EosinY/ElectronicLoad-AnalogController/GreenPAK_schem.pdf

(

)

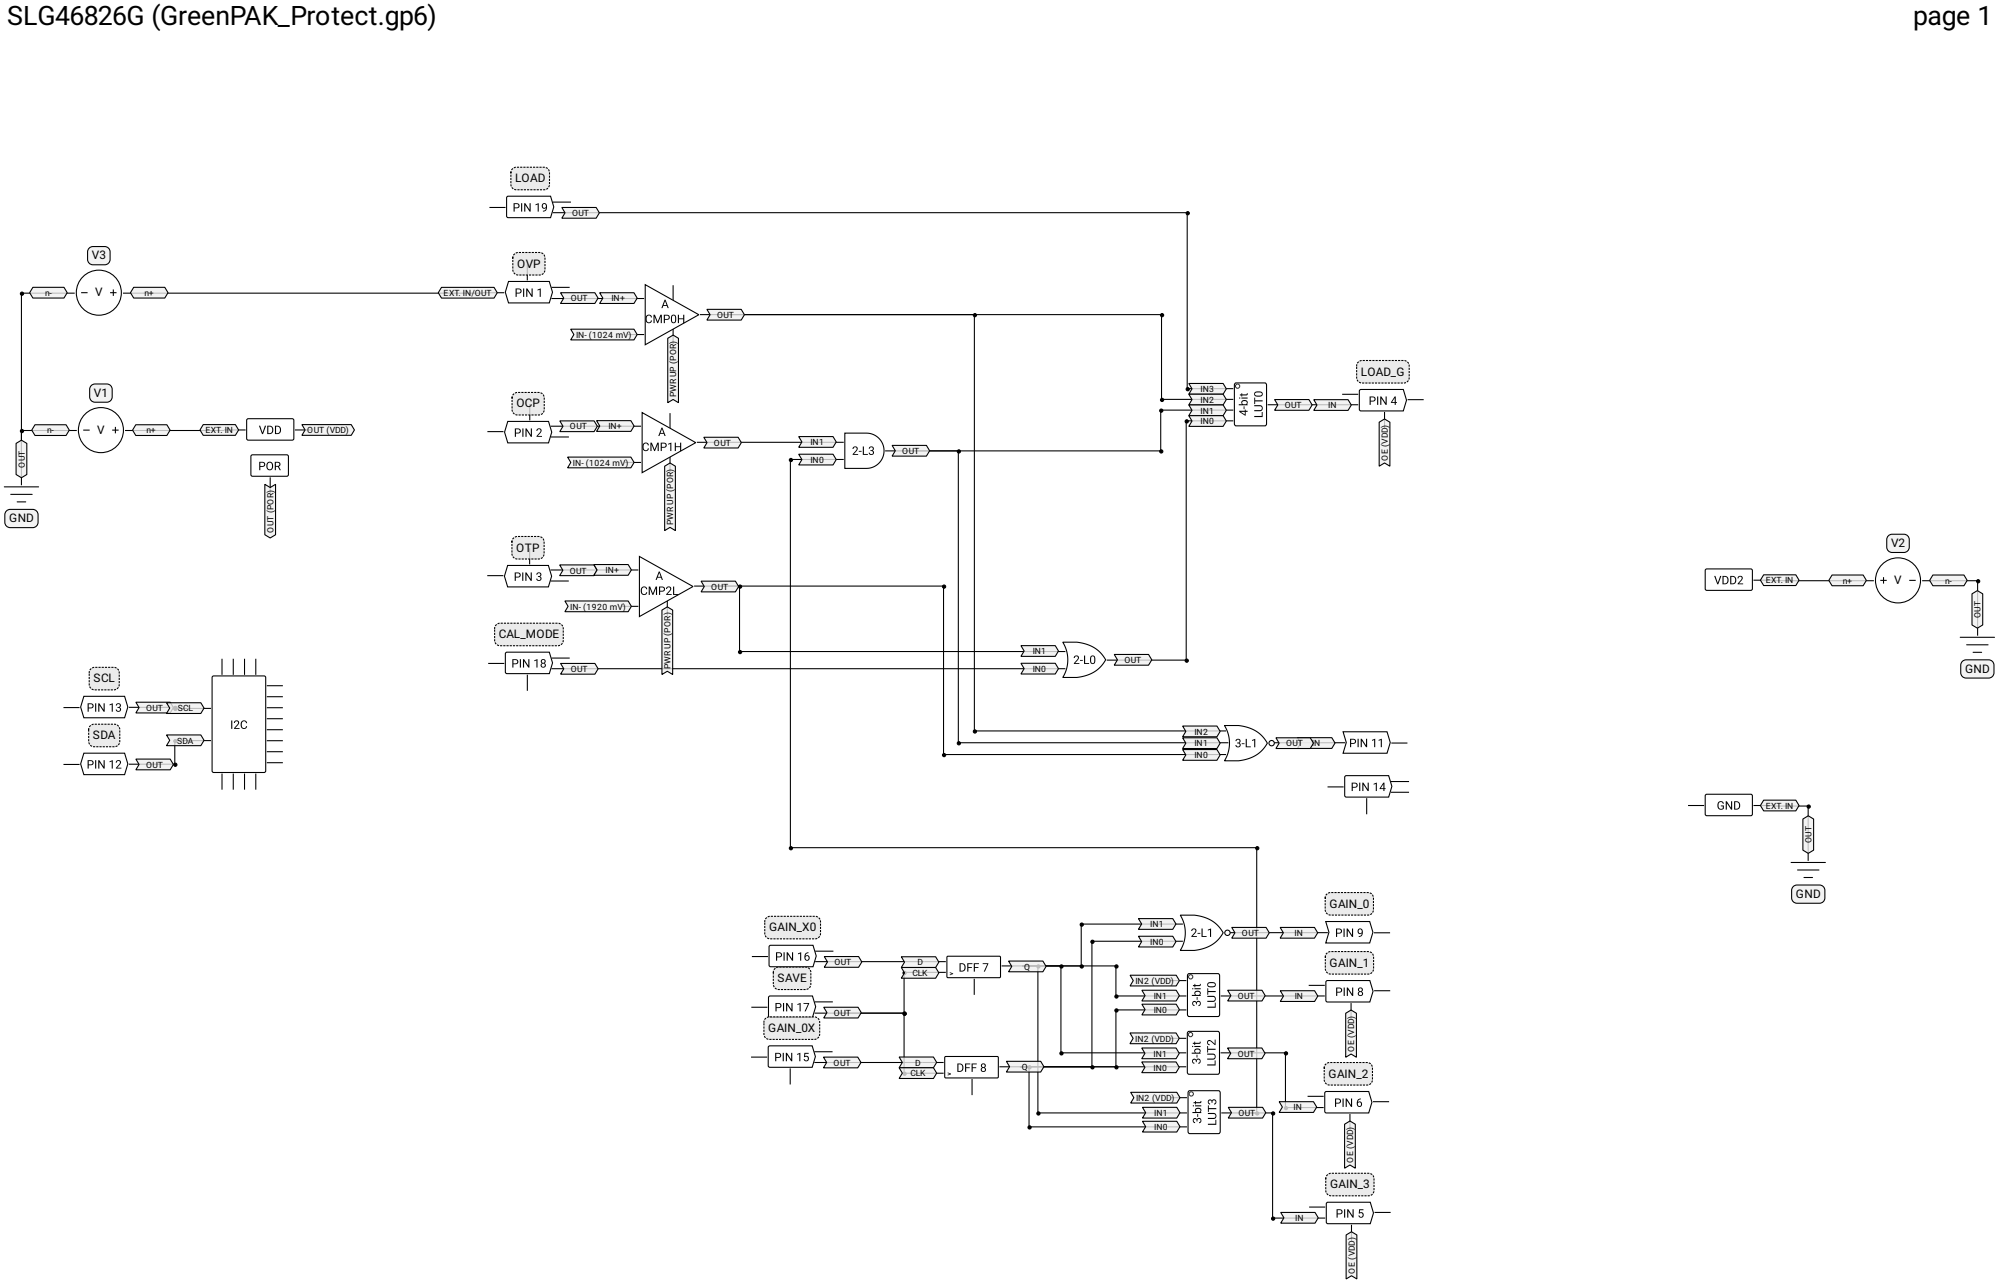
[picture p1: page 1]
AIN; OUT; IN2 (VDD) IN1 IN0; OUT IN2 IN1 IN0; T IN2 (VDD) IN1 IN0; OUT IN2 (VDD) IN1 IN0

PWR UP (POR) IN+ IN- (1024 mV)

OE (VDD) IN LOAD

PWR UP (POR) IN+ IN- (1920 mV)

OUT (POR) IN

PWR UP (POR)

OE (VDD) IN GAIN

V

D

D

I

N

2

0

Pr o p e r ty | Va l u e
Min. v alu ( V ) e | 2.3 0
T
y
p. v

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
x. v

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
Pr o p e r ty | Va l u
| Digital input In mode Digital in without Sch e I/O selection

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
Pr o p e r ty | l Va u
| Digital input In mode Digital in without Sch e I/O selection

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
ull D
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
Pr o p e r ty | l Va u
e I/O selection | Digital input In mode | Digital in without Sch

mit
t

t

rig
g

e

r
O u t m o d e | N o n e
R sis e t o r | Flo tin a g

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
Pr o p e r ty | Va l u
| Digital input In mode Digital in without Sch e I/O selection
| mit t t rig g e r
O d u m | N
R sis | Flo tin

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
e I/O selection | Digital input In mode | Digital in without Sch

mit
t

t

rig
g

e

r
O u t m o d e | N o n e
R e sis t o r | Flo a tin g

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
Pr o p e r ty | l Va u
e I/O selection | Digital input In mode | Digital in without Sch

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
Pr o p e r ty | Va l u
e I/O selection | Digital input In mode | Digital in without Sch

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
Pr o p e r ty | Va l u
| Digital input In mode Digital in without Sch e I/O selection

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
e I/O selection | Digital output In mode | None Out mode | 2x push pull | P

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
e I/O selection | Digital output In mode | None Out mode | 1x push pull PIN 8 (IO8) Label: "GAIN_1" Property | Value I/O selection | Digital output In mode | None Out mode | 1x push pull VDD2 (PIN 7) Property | Value Min. value (V) | 1.71 Typ. value (V) | 5.00 Max. value (V) | 5.50 PIN 6 (IO9) Label: "GAIN_2" Property | Value I/O selection | Digital output In mode | None Out mode | 1x push pull PIN 5 (IO10) Label: "GAIN_3" Property | Value I/O selection | Digital output In mode | None Out mode | 1x push pull SLG46826G (GreenPAK_Protect.gp6)

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
Pr o p e r ty | Va l u
e I/O selection | Digital output In mode | None Out mode | 1x push pull PIN 3 (IO12) Label: "OTP" Property | Value I/O selection | Analog input/output In mode | Analog input/output Out mode | Analog input/output Resistor | Floating PIN 2 (IO13) Label: "OCP" Property | Value I/O selection | Analog input/output In mode | Analog input/output Out mode | Analog input/output Resistor | Pull Down Resistor value | 1M PIN 1 (IO14) Label: "OVP" Property | Value I/O selection | Analog input/output In mode | Analog input/output Out mode | Analog input/output Resistor | Pull Down Resistor value | 1M 100uA pullup on input | Enable

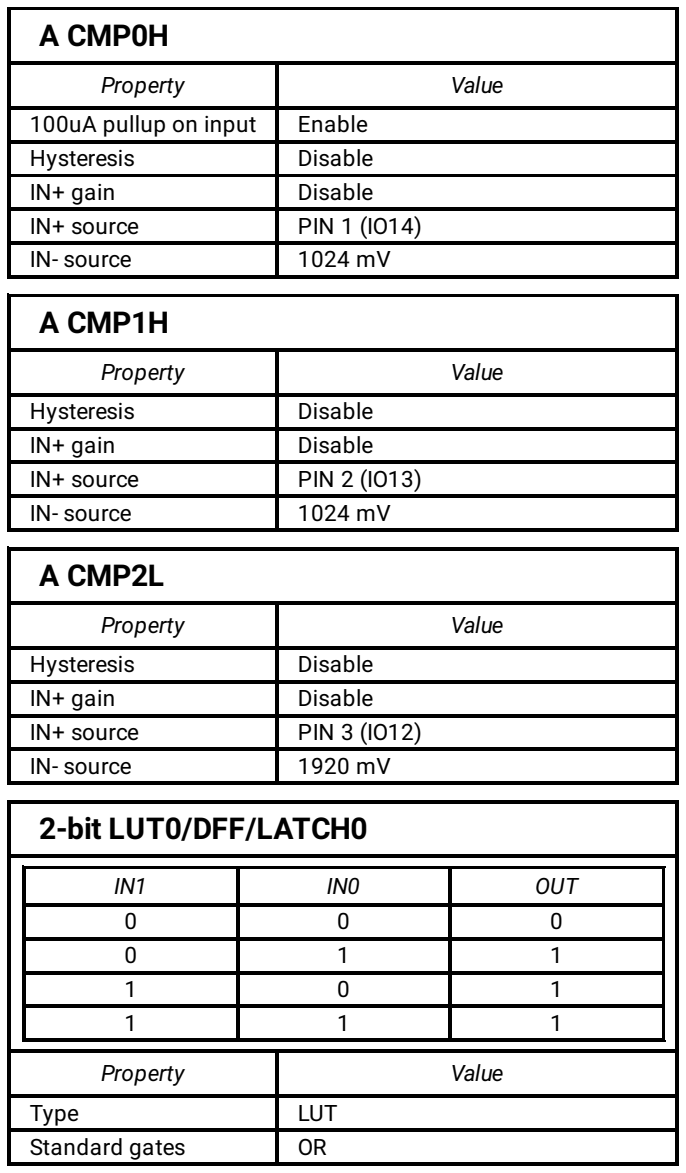
[picture p2: figure]
ullu; ble; sis; Dis a; ble IN+ gain; Disable IN+ source; PIN 1 (IO; ) IN- source; 1024 mV A CMP1H Property; 1024 mV A CMP2L Property; H sis y s t e r e; PIN 3 (IO; 1920 mV 2-bit LUT0/DFF/LATCH0 IN1

Disable IN+ source PIN 2 (IO ble IN+ gain

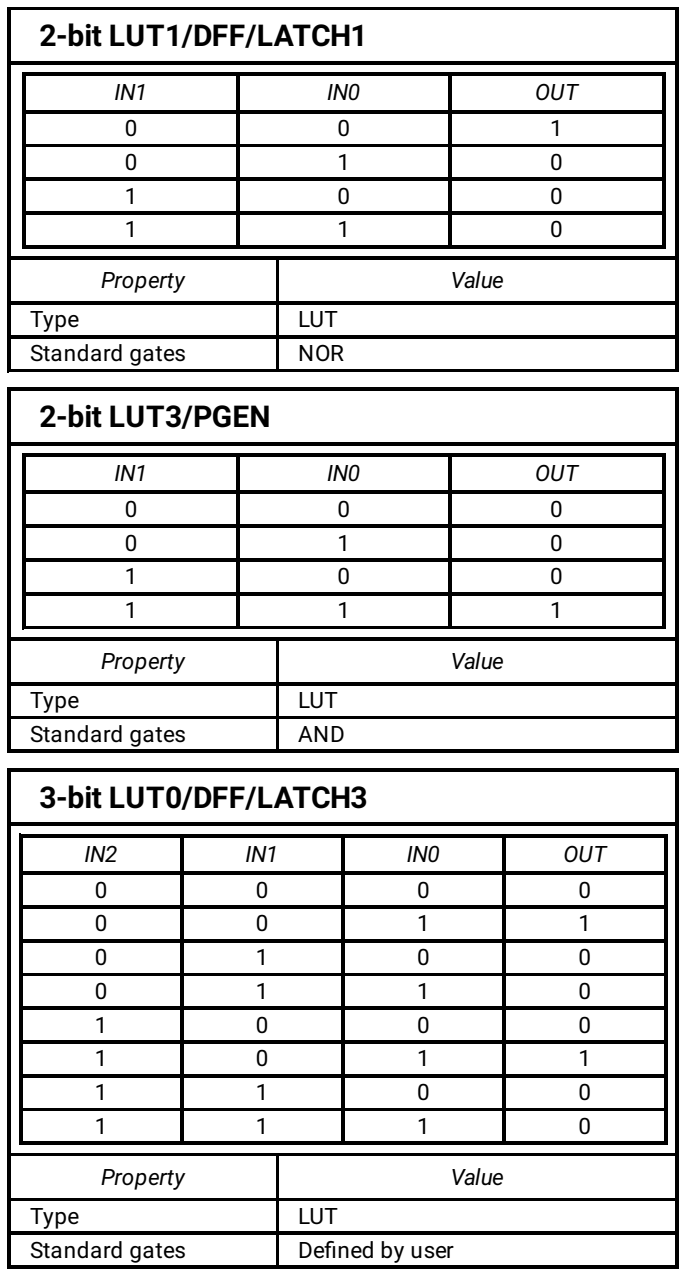
[picture p3: figure]
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

### 3-bit LUT1/DFF/LATCH4

IN2 | IN1 | IN0 | OUT
0 | 0 | 0 | 1
0 | 0 | 1 | 0
0 | 1 | 0 | 0
0 | 1 | 1 | 0
1 | 0 | 0 | 0
1 | 0 | 1 | 0
1 | 1 | 0 | 0
1 | 1 | 1 | 0
Property | Value
Type | LUT
Standard gates | NOR

### 3-bit LUT2/DFF/LATCH5

IN2 | IN1 | IN0 | OUT
0 | 0 | 0 | 0
0 | 0 | 1 | 0
0 | 1 | 0 | 1
0 | 1 | 1 | 0
1 | 0 | 0 | 0
1 | 0 | 1 | 0
1 | 1 | 0 | 1
1 | 1 | 1 | 0
Property | Value
Type | LUT
Standard gates | Defined by user

### 3-bit LUT3/DFF/LATCH6

IN2 | IN1 | IN0 | OUT
0 | 0 | 0 | 0
0 | 0 | 1 | 0
0 | 1 | 0 | 0
0 | 1 | 1 | 1
1 | 0 | 0 | 0
1 | 0 | 1 | 0
1 | 1 | 0 | 0
1 | 1 | 1 | 1
Property | Value
Type | LUT
Standard gates | | Defined by user

### 3-bit LUT4/DFF/LATCH7

Property | Value
Type | DFF / LATCH
Mode | DFF
nSET/nRESET option | nRESET
Initial polarity | Low
Q output polarity | | Non-inverted (Q)

### 3-bit LUT5/DFF/LATCH8

Property | Value
Type | DFF / LATCH
Mode | DFF
nSET/nRESET option | nRESET
Initial polarity | Low
Q output polarity | Non-inverted (Q)

### MF0 (4-bit LUT0, DFF/LATCH9, WS Ctrl, 16-bit CNT0/DLY0/FSM0)

### 4-bit LUT0 (MF0)

IN3 | IN2 | IN1 | IN0 | OUT
0 | 0 | 0 | 0 | 0
0 | 0 | 0 | 1 | 0
0 | 0 | 1 | 0 | 0
0 | 0 | 1 | 1 | 0
0 | 1 | 0 | 0 | 0
0 | 1 | 0 | 1 | 0
0 | 1 | 1 | 0 | 0
0 | 1 | 1 | 1 | 0
1 | 0 | 0 | 0 | 1
1 | 0 | 0 | 1 | 0
1 | 0 | 1 | 0 | 0
1 | 0 | 1 | 1 | 0
1 | 1 | 0 | 0 | 0
1 | 1 | 0 | 1 | 0
1 | 1 | 1 | 0 | 0
1 | 1 | 1 | 1 | 0
Property | Value
Standard gates | Defined by user
SLG46826G (GreenPAK_Protect.gp6) | page 4

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
e IO Latching | Enable Mode selection | Standard/fast mode Control code, bin | 0001 Control byte, read/ write | 0x11 / 0x10 Device address, dec/ hex | 8 / 0x08 PIN 19 (IO0) output expander select | From matrix PIN 14 (IO5) output expander select | From matrix PIN 11 (IO6) output expander select | From matrix PIN 6 (IO9) output expander select | From matrix Virtual OUT0 | 0 Virtual OUT1 | 0 Virtual OUT2 | 0 Virtual OUT3 | 0 Virtual OUT4 | 0 Virtual OUT5 | 0 Virtual OUT6 | 0 Virtual OUT7 | 0 PIN 19 (IO0) OUT | 0 PIN 14 (IO5) OUT | 0 PIN 11 (IO6) OUT | 0 PIN 6 (IO9) OUT | 0 Control code selection | #3 | #2
| | # 1 | # 0
0 | 0 | 0 | 1

V

1

Pr o p e r ty | l Va u e
Ele m e n t | V olt a g e S o u r c e
P d ela r e -s t a r t y | 0 10 s Internal capacitance
| 0 n
F Internal resistance | 10Ohm Pre-start state | Low Type | DC DC Voltage | 3.3V Ramp rise time | 1ms V2 Property
| Va l u e
Ele m e n t | olt V a g e S o u r c e
P r e -s t a r t d ela y | 0 10 s Internal capacitance
| 0 n
F Internal resistance | 10Ohm Pre-start state | Low Type | DC DC Voltage | 3.3V Ramp rise time | 1ms V3 Property
| Va l u e
Ele m e n t | V olt S a g e o u r c e
T y p e | D C
D C V olt a g e | 3.3 V

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
n. | Typ. | M
ax. VDD | 2.30 | 5.00 | 5.50 VDD2 (V): | 1.71 | 5.00 | 5.50 Temperature (°C): | -40.00 | 25.00 | 85.00 General Settings GPIO quick charge | Disable Pattern ID | 1 2k Register lock status | Unlocked 2k NVM lock status | Unlocked Emulated EEPROM lock status | Unlocked Protect entire lock configuration | Disable

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
X: 0
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
C: 1
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
X: 0
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
C: 1
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
X: 0
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
C: 1
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
X: 0
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
C: 1
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
X: 0
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
C: 1
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
X: 0
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
C: 1
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
X: 0
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
C: 1
1
6

`

b
6

PIN 8 (IO 8 ) -> O U T | H E X: 0 x 7 4 ` b 7 ` b D E C: 1 1 6 7 | -
(IO ) PIN 6 9 -> O U T | ` b H E X: 0 x 7 5 0 D E C: 1 1 7 ` b 0 | -
PIN 5 (IO 1 0 ) -> O U T | H E X: 0 x 7 5 ` b 1 ` b D E C: 1 1 7 1 | -
(IO ) PIN 4 1 1 -> O U T | ` b H E X: 0 x 7 5 2 D E C: 1 1 7 ` b 2 | -

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
X: 0
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
C: 1
1
7

`

b
3

(IO ) PIN 2 1 3 -> O U T | N E T 9 | ` b H E X: 0 x 7 5 4 D E C: 1 1 7 ` b 4 | -
PIN 1 (IO 1 4 ) -> O U T | N E T 8 | H E X: 0 x 7 5 ` b 5 ` b D E C: 1 1 7 5 | -
bit 2 -L U T 0 / D F F / L AT C H 0 -> O U T | N E T 2 2 | ` b H E X: 0 x 7 5 6 D E C: 1 1 7 ` b 6 | +

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
X: 0
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
C: 1
1
7

`

b
7

+

bit -U T / D F F / AT H -> O U T | | ` b H E X: 0 x D E C: 1 ` b | -
-bit U T / E N -> | N E T | H E X: 0 x ` b | +

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
C: 1
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
X: 0
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
C: 1
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
X: 0
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
C: 1
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
X: 0
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
C: 1
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
X: 0
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
C: 1
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
X: 0
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
C: 1
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
X: 0
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
C: 1
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
X: 0
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
C: 1
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
X: 0
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
C: 1
1

9

`

b
1

bit 3 -L U T 6 / Pip e D ela y / Rip ple C o u n t e r -> Q 2 | ` b H E X: 0 x 7 7 2 D E C: 1 1 9 ` b 2 | -
FILT E R/ E D G E D E T -> O U T | ` b H E X: 0 x 7 7 3 D E C: 1 1 9 ` b 3 | -

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
X: 0
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
C: 1
1

9

`

b
4

bit 8 -C N T 1 / D LY 1 ( M F 1 ) -> O U T | ` b H E X: 0 x 7 7 5 D E C: 1 1 9 ` b 5 | -
O S C 1 -> O U T 0 | H E X: 0 x 7 7 ` b 6 ` b D E C: 1 1 9 6 | -
O S C 0 -> O U T 0 | ` b H E X: 0 x 7 7 7 D E C: 1 1 9 ` b 7 | -

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
X: 0
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
C: 1

2

0

`

b
0

bit -N T / D LY M F -> O U T | ` b H E X: 0 x D E C: 1 ` b | -

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
X: 0
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
C: 1

2

0

`

b
2

8 -bit C N T 4 / D LY 4 ( ) M F 4 -> O U T | | H E X: 0 x 7 8 ` b 3 ` b D E C: 1 2 0 3 | -
bit 8 -C N T 5 / D LY 5 ( M F 5 ) -> O U T | | ` b H E X: 0 x 7 8 4 D E C: 1 2 0 ` b 4 | -
8 -bit C N T 6 / D LY 6 ( ) M F 6 -> O U T | | H E X: 0 x 7 8 ` b 5 ` b D E C: 1 2 0 5 | -
bit 8 -C N T 7 / D LY 7 ( M F 7 ) -> O U T | | ` b H E X: 0 x 7 8 6 D E C: 1 2 0 ` b 6 | -
4 -bit L U T 0 ( M F 0 ) -> O U T | N E T 2 7 | H E X: 0 x 7 8 ` b 7 ` b D E C: 1 2 0 7 | +
bit ( ) 3 -L U T 7 M F 1 -> O U T | | ` b H E X: 0 x 7 9 0 D E C: 1 2 1 ` b 0 | -
3 -bit L U T 8 ( M F 2 ) -> O U T | | H E X: 0 x 7 9 ` b 1 ` b D E C: 1 2 1 1 | -

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
X: 0
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
C: 1

2
1

`

b
2

3 -bit L U T 1 0 ( M F 4 ) -> O U T | H E X: 0 x 7 9 ` b 3 ` b D E C: 1 2 1 3 | -
bit ( ) 3 -L U T 1 1 M F 5 -> O U T | ` b H E X: 0 x 7 9 4 D E C: 1 2 1 ` b 4 | -
3 -bit L U T 1 2 ( M F 6 ) -> O U T | H E X: 0 x 7 9 ` b 5 ` b D E C: 1 2 1 5 | -
bit ( ) 3 -L U T 1 3 M F 7 -> O U T | ` b H E X: 0 x 7 9 6 D E C: 1 2 1 ` b 6 | -
1 6 -bit C N T 0 / D LY 0 / ( ) F S M 0 M F 0 -> O U T | H E X: 0 x 7 9 ` b 7 ` b D E C: 1 2 1 7
| HEX: 0x7A`b0 DEC: 122`b0 HEX: 0x7A`b1 DEC: 122`b1 HEX: 0x7A`b2 DEC: 122`b2 HEX: 0x7A`b3 DEC: 122`b3 | - I2C -> OUT7 - I2C -> OUT6 - I2C -> OUT5 - I2C -> OUT4 -

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
s I2C -> OUT3

` b H E X: 0 x 7 A 4 D E C: 1 2 2 ` b 4
HEX: 0x7A`b5 DEC: 122`b5 HEX: 0x7A`b6 DEC: 122`b6 HEX: 0x7A`b7 DEC: 122`b7 | - I2C -> OUT2 - I2C -> OUT1 - I2C -> OUT0 -
A C M P 0 H -> O U T | N E T 1 4 | ` b H E X: 0 x 7 B 0 D E C: 1 2 3 ` b 0 | +
A C M P 1 H -> O U T | N E T 1 5 | H E X: 0 x 7 B ` b 1 ` b D E C: 1 2 3 1 | +
A C M P 2 L -> O U T | N E T 1 3 | ` b H E X: 0 x 7 B 2 D E C: 1 2 3 ` b 2 | +
A C M P 3 L -> O U T | | H E X: 0 x 7 B ` b 3 ` b D E C: 1 2 3 3 | -
O S C 1 -> O U T 1 | | ` b H E X: 0 x 7 B 4 D E C: 1 2 3 ` b 4 | -
O S C 0 -> O U T 1 | | H E X: 0 x 7 B ` b 5 ` b D E C: 1 2 3 5 | -
P O R -> O U T | P O R | ` b H E X: 0 x 7 B 6 D E C: 1 2 3 ` b 6 | +
V D D ( PIN 2 0 ) -> O U T | V D D | H E X: 0 x 7 B ` b 7 ` b D E C: 1 2 3 7 | +

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
M l l a c r o c e | Pr o p e r ty | R i e g s t e r
1 6 bit C N T 0 / D LY 0 / -F S M 0 ( M F 0 ) | C d D o u n t e a t a | H E X: 0 7 C 0 7 D x , x D E C: 1 2 4 , 1 2 5
8 -bit C N T 2 / D LY 2 ( M F 2 ) | C o u n t e d D a t a | H E X: 0 x 7 E D E C: 126
8 bit C N T 4 / D LY 4 ( M F 4 ) - | C d D o u n t e a t a | H E X: 0 7 F D E C: 127 x
