EosinY/ElectronicLoad-AnalogController/Main_SMD_Controller_v2.csv

DNP | Reference | Qty | In_Stock | Value | Akizuki_code | Akizuki_code2 | Marutsu_code | Sengoku_code | Footprint | Datasheet
 | C101,C102,C103,C104,C111,C112,C115,C116,C117,C118,C119,C121,C122,C124,C125,C201,C202,C210,C211,C301,C302,C303,C304,C305,C306,C309 | 26 | 77 | 0.1u | 105728 | 116143 |  |  | Capacitor_SMD:C_0603_1608Metric | https://akizukidenshi.com/goodsaffix/umk107f104za-t.pdf
 | C105,C106,C107,C108 | 4 | 4 | 47u | 114453 |  |  |  | Capacitor_SMD:CP_Elec_6.3x5.9 | https://akizukidenshi.com/goodsaffix/j_pfv.pdf
 | C109,C110 | 2 | 11 | 1u | 114526 | 116994 |  |  | Capacitor_SMD:C_0603_1608Metric | https://akizukidenshi.com/goodsaffix/GRM188R71E105KA12.pdf
 | C113,C114 | 2 | 0 | 4.7u | 115634 |  |  |  | Capacitor_SMD:C_1210_3225Metric | https://akizukidenshi.com/goodsaffix/GRM31CR71H475KA12.pdf
 | C207,C208,C212 | 3 | 0 | 1000p(FL) | 115631 |  |  | EEHD-5PLN | Capacitor_SMD:C_0805_2012Metric | https://akizukidenshi.com/goodsaffix/GRM21B5C2E103FWAA.pdf
 | C307,C308,C310,C311,C312 | 5 | 0 | 1000p | 102332 |  |  | EEHD-6WFB | Capacitor_SMD:C_0603_1608Metric | https://akizukidenshi.com/goodsaffix/GRM188B11H102KA01.pdf
 | D101 | 1 | 6 | GS1010FL | 106014 |  |  |  | Diode_SMD:D_SOD-123F | https://akizukidenshi.com/goodsaffix/GS1000FL_SERIES.pdf
 | D301 | 1 | 0 | OSBL1608C1A | 103982 |  |  |  | LED_SMD:LED_0603_1608Metric
 | D302 | 1 | 0 | OSHR1608C1A | 103978 |  |  |  | LED_SMD:LED_0603_1608Metric | https://akizukidenshi.com/goodsaffix/OSXX1608C1A_ver_a_10.pdf
 | D303 | 1 | 0 | OSYG1608 | 103980 |  |  |  | LED_SMD:LED_0603_1608Metric | https://akizukidenshi.com/goodsaffix/OSXX1608C1A_ver_a_10.pdf
 | FB101,FB102 | 2 | 0 | BLM21PG331SN | 113369 |  |  |  | Inductor_THT:L_Axial_L5.3mm_D2.2mm_P2.54mm_Vertical_Vishay_IM-1 | https://akizukidenshi.com/goodsaffix/BL01RN1A1D2.pdf
 | FB103,FB104 | 2 | 0 | BLM21PG331SN | 104053 |  |  |  | Inductor_SMD:L_0805_2012Metric | https://akizukidenshi.com/goodsaffix/BLM21PG331SN.pdf
 | HS201 | 1 | 1 | Heatsink_Pad_2Pin | 112537 |  |  |  | AM_Heatsink:Heatsink_61x30x30
 | J101,J102 | 2 | 3 | ETB43034G000Z | 111600 |  |  |  | AM_Conn_ScrewTerminal:EurostylePluggable_1x03_P5.08mm | https://akizukidenshi.com/goodsaffix/etb43.pdf
 | J105 | 1 | 0 | B2P3-VH-3.3 | 115084 |  |  |  | Connector_JST:JST_VH_B2P3-VH_1x02_P7.92mm_Vertical | https://akizukidenshi.com/goodsaffix/va.pdf
 | J106,J303 | 2 | 23 | PH-1X3SG | 103949 |  |  |  | Connector_PinHeader_2.54mm:PinHeader_1x03_P2.54mm_Vertical | https://akizukidenshi.com/goodsaffix/PH-1xXXSG_20260114.pdf
 | J107,J109,J111,J112 | 4 | 8 | PCB-20 | 112148 |  |  |  | AM_Conn_ScrewTerminal:ScrewTerminal_01x01_PCB-20 | https://akizukidenshi.com/goodsaffix/PCB-20(362)F.pdf
 | J108,J304 | 2 | 8 | B2B-XH-A | 112247 |  |  |  | Connector_JST:JST_XH_B2B-XH-A_1x02_P2.50mm_Vertical | https://akizukidenshi.com/goodsaffix/xh.pdf
 | J110 | 1 | 10 | PH-1X2SG | 108593 |  |  |  | Connector_PinHeader_2.54mm:PinHeader_1x02_P2.54mm_Vertical | https://akizukidenshi.com/goodsaffix/PH-1xXXSG_20260114.pdf
 | J301 | 1 | 0 | BH-14SG | 110901 |  |  |  | Connector_IDC:IDC-Header_2x07_P2.54mm_Vertical | https://akizukidenshi.com/goodsaffix/BH-xxSG_20260114.pdf
 | J302 | 1 | (Cut) | PH-2x3SG | 116883 |  |  |  | Connector_PinHeader_2.54mm:PinHeader_2x03_P2.54mm_Vertical | https://akizukidenshi.com/goodsaffix/PH-2xXXSG.pdf
 | Q201 | 1 | 61 | 2SC1815 | 117089 |  |  |  | Package_TO_SOT_THT:TO-92L_Inline | https://akizukidenshi.com/goodsaffix/2sc1815_jcet.pdf
 | Q202,Q204 | 2 | 4 | 2SD1415A | 110058 | 106369 |  |  | Package_TO_SOT_THT:TO-220-3_Vertical | https://akizukidenshi.com/goodsaffix/TTD1415Bj.pdf
 | Q203,Q205 | 2 | 1 | TTB1020B | 117309 |  |  |  | Package_TO_SOT_THT:TO-220-3_Vertical | https://akizukidenshi.com/goodsaffix/TTB1020B_datasheet_ja_20200129.pdf
 | Q301,Q302,Q304,Q305 | 4 | 16 | 2N7002K | 104256 |  |  |  | Package_TO_SOT_SMD:SOT-23 | https://akizukidenshi.com/goodsaffix/2N7002K.pdf
 | Q303 | 1 | 0 | BSS84 | 104269 |  |  |  | Package_TO_SOT_SMD:SOT-23 | https://akizukidenshi.com/goodsaffix/BSS84.pdf
 | R101,R109 | 2 | 0 | 1k(0.1) | 111796 |  |  |  | Resistor_SMD:R_0805_2012Metric | https://akizukidenshi.com/goodsaffix/rg.pdf
 | R102 | 1 | 0 | 150(0.5) |  |  | M0083-1395 |  | Resistor_THT:R_Axial_DIN0207_L6.3mm_D2.5mm_P2.54mm_Vertical | https://www.marutsu.co.jp/contents/shop/marutsu/datasheet/LMFQ50S.pdf
 | R103 | 1 | 0 | 470(0.5) |  |  |  |  | Resistor_THT:R_Axial_DIN0207_L6.3mm_D2.5mm_P2.54mm_Vertical | https://www.marutsu.co.jp/contents/shop/marutsu/datasheet/LMFQ50S.pdf
 | R104 | 1 | 0 | 1.5k |  |  |  |  | Resistor_THT:R_Axial_DIN0207_L6.3mm_D2.5mm_P2.54mm_Vertical | https://www.marutsu.co.jp/contents/shop/marutsu/datasheet/LMFQ50S.pdf
 | R105 | 1 | 0 | 4.7k |  |  |  |  | Resistor_THT:R_Axial_DIN0207_L6.3mm_D2.5mm_P2.54mm_Vertical | https://www.marutsu.co.jp/contents/shop/marutsu/datasheet/LMFQ50S.pdf
 | R106,R108,R114 | 3 | 10 | 10k(0.1) | 111797 |  |  |  | Resistor_SMD:R_0805_2012Metric | https://akizukidenshi.com/goodsaffix/rg.pdf
 | R107 | 1 | 0 | 2.2k(0.5) |  |  | M0083-1404 |  | Resistor_THT:R_Axial_DIN0207_L6.3mm_D2.5mm_P10.16mm_Horizontal | https://www.marutsu.co.jp/contents/shop/marutsu/datasheet/LMFQ50S.pdf
 | R110 | 1 | 0 | 39k(0.5) |  |  | M0223-1635 |  | Resistor_THT:R_Axial_DIN0207_L6.3mm_D2.5mm_P10.16mm_Horizontal | https://www.marutsu.co.jp/contents/shop/marutsu/datasheet/LMFQ50S.pdf
 | R111 | 1 | 0 | 1k(0.5) |  |  | M0083-1389 |  | Resistor_THT:R_Axial_DIN0207_L6.3mm_D2.5mm_P10.16mm_Horizontal | https://www.marutsu.co.jp/contents/shop/marutsu/datasheet/LMFQ50S.pdf
 | R112,R115,R318,R319 | 4 | 51 | 0 |  |  |  | EEHD-57HU | Resistor_SMD:R_0805_2012Metric | https://akizukidenshi.com/goodsaffix/rk73z.pdf
 | R113 | 1 | 5 | 100k(0.1) | 111798 |  |  |  | Resistor_SMD:R_0805_2012Metric | https://akizukidenshi.com/goodsaffix/rg.pdf
 | R116,R320,R321,R322,R323,R324 | 6 | >100 | 200 | 106201 |  |  |  | Resistor_SMD:R_0603_1608Metric | https://akizukidenshi.com/goodsaffix/rc.pdf
 | R117 | 1 | 0 | BR3FB10L0 (10m) |  |  | M2807-4003 |  | Resistor_THT:R_Bare_Metal_Element_L16.3mm_W4.8mm_P15.30mm | https://www.seielect.com/catalog/SEI-BR.pdf
 | R201,R203,R207,R208 | 4 | 92 | 0 | 111619 |  |  |  | Resistor_SMD:R_0603_1608Metric | https://akizukidenshi.com/goodsaffix/rk73z.pdf
 | R202,R218,R303,R305,R316 | 5 | 170 | 1k | 114122 |  |  |  | Resistor_SMD:R_0603_1608Metric | https://akizukidenshi.com/goodsaffix/rc.pdf
 | R204,R205 | 2 | 75 | 1M | 130359 |  |  |  | Resistor_SMD:R_0603_1608Metric | https://akizukidenshi.com/goodsaffix/rk73b.pdf
 | R209,R301,R302,R304,R306,R307,R308,R309,R310,R311,R312,R313,R314,R315,R317 | 15 | >100 | 10k | 115029 |  |  |  | Resistor_SMD:R_0603_1608Metric | https://akizukidenshi.com/goodsaffix/rc.pdf
 | R210 | 1 | 50 | 100k | 115321 |  |  |  | Resistor_SMD:R_0603_1608Metric | https://akizukidenshi.com/goodsaffix/rc.pdf
 | R211 | 1 | 0 | 3.3k |  |  |  | EEHD-57C5 | Resistor_SMD:R_0805_2012Metric
 | R212,R214 | 2 | 0 | 510 |  |  |  | EEHD-0ECM | Resistor_SMD:R_2512_6332Metric
 | R213 | 1 | 0 | 1k |  |  |  | EEHD-57BZ | Resistor_SMD:R_0805_2012Metric
 | R215 | 1 | 0 | 33k |  |  |  | EEHD-57CH | Resistor_SMD:R_0805_2012Metric
 | R216,R217,R221,R222 | 4 | 0 | 470 |  |  |  | EEHD-57BS | Resistor_SMD:R_1206_3216Metric
 | R219,R220,R223,R224 | 4 | 0 | 1 | 110701 |  |  |  | Resistor_THT:R_Box_L14.0mm_W5.0mm_P9.00mm | https://akizukidenshi.com/goodsaffix/35_ext_08_0.pdf
 | RLY101 | 1 | 0 | 943-1C-5DS | 117417 |  |  |  | AM_Relay:HSINDA-943_12A-1C_5p | https://akizukidenshi.com/goodsaffix/943.pdf
 | RV101 | 1 |  | 10 | 101036 |  |  |  | Potentiometer_THT:Potentiometer_Bourns_3296W_Vertical
 | RV102 | 1 |  | 50 |  |  |  |  | Potentiometer_THT:Potentiometer_Bourns_3296W_Vertical
 | RV103 | 1 |  | 200 |  |  |  |  | Potentiometer_THT:Potentiometer_Bourns_3296W_Vertical
 | RV104 | 1 |  | 500 |  |  |  |  | Potentiometer_THT:Potentiometer_Bourns_3296W_Vertical
 | RV201 | 1 | 21 | 2k | 106061 |  |  |  | AM_Potentiometer:TSR-065-xxx-R | https://akizukidenshi.com/goodsaffix/tsr-065.pdf
 | TP101,TP102,TP103,TP104,TP201,TP202,TP301 | 7 | 0 | RCTCTE | 131773 |  |  |  | AM_Conn_TP:RCTCE | https://akizukidenshi.com/goodsaffix/checker_rc.pdf
 | U101 | 1 | 2 | XC6201P332MR-G | 115649 |  |  |  | Package_TO_SOT_SMD:SOT-23-5 | https://akizukidenshi.com/goodsaffix/XC6201.pdf
 | U102 | 1 | 0 | XC6902N331MR-G | 115651 |  |  |  | Package_TO_SOT_SMD:SOT-23-3 | https://akizukidenshi.com/goodsaffix/XC6902.pdf
 | U103 | 1 | 5 | TC4066BP | 131725 |  |  |  | Package_DIP:DIP-14_W7.62mm | https://akizukidenshi.com/goodsaffix/TC4066B.pdf
 | U104 | 1 | 2 | ADA4510-2ARZ | 118321 | 114063 |  |  | Package_SO:SOIC-8_3.9x4.9mm_P1.27mm | https://akizukidenshi.com/goodsaffix/ada4510-2.pdf
 | U105 | 1 | 0 | MCP1501-20E/CHY | 115203 |  |  |  | Package_TO_SOT_SMD:SOT-23-6 | https://akizukidenshi.com/goodsaffix/mcp1501_j.pdf
 | U106 | 1 | 1 | AD623ANZ | 112706 |  |  |  | Package_DIP:DIP-8_W7.62mm | https://akizukidenshi.com/goodsaffix/AD623_jp.pdf
 | U107 | 1 | 0 | NJU7098A | 114988 |  |  |  | Package_TO_SOT_SMD:SOT-23-6 | https://akizukidenshi.com/goodsaffix/nju7098a_j.pdf
 | U201 | 1 | 2 | ADA4522-1ARZ | 115092 | 114063 |  |  | Package_SO:SOIC-8_3.9x4.9mm_P1.27mm | https://akizukidenshi.com/goodsaffix/ada4522.pdf
 | U202 | 1 | 0 | KIA75S358F | 109229 |  |  |  | Package_TO_SOT_SMD:SOT-23-5 | https://akizukidenshi.com/goodsaffix/KIA75S358F.pdf
 | U301 | 1 | 0 | 74LCX541FT | 114112 |  |  |  | Package_SO:TSSOP-20_4.4x6.5mm_P0.65mm | https://akizukidenshi.com/goodsaffix/74LCX541FT_datasheet_ja_20181030.pdf
 | U302 | 1 | 0 | SLG46826G | 118384 |  |  |  | Package_SO:TSSOP-20_4.4x6.5mm_P0.65mm | https://akizukidenshi.com/goodsaffix/REN_SLG46826_ds_3v20_DST_20231130.pdf
 | U303 | 1 | 0 | PCA9515AD | 110882 |  |  |  | Package_SO:SOIC-8_3.9x4.9mm_P1.27mm | https://akizukidenshi.com/goodsaffix/PCA9515.pdf
 | U304 | 1 | 0 | MCP4726A0T-ECH | 107611 |  |  |  | Package_TO_SOT_SMD:SOT-23-6 | https://akizukidenshi.com/goodsaffix/MCP4726.pdf
 | U305 | 1 | 1 | MCP3424T-ESL | 111989 |  |  |  | Package_SO:SOIC-14_3.9x8.7mm_P1.27mm | https://akizukidenshi.com/goodsaffix/mcp342x.pdf
 | U306 | 1 | 0 | MCP9701A-E_TO | 103199 |  |  |  | Package_TO_SOT_THT:TO-92_Inline | https://akizukidenshi.com/goodsaffix/MCP9701-ETO.pdf
