EosinY/ElectronicLoad-AnalogController/BOM.pdf

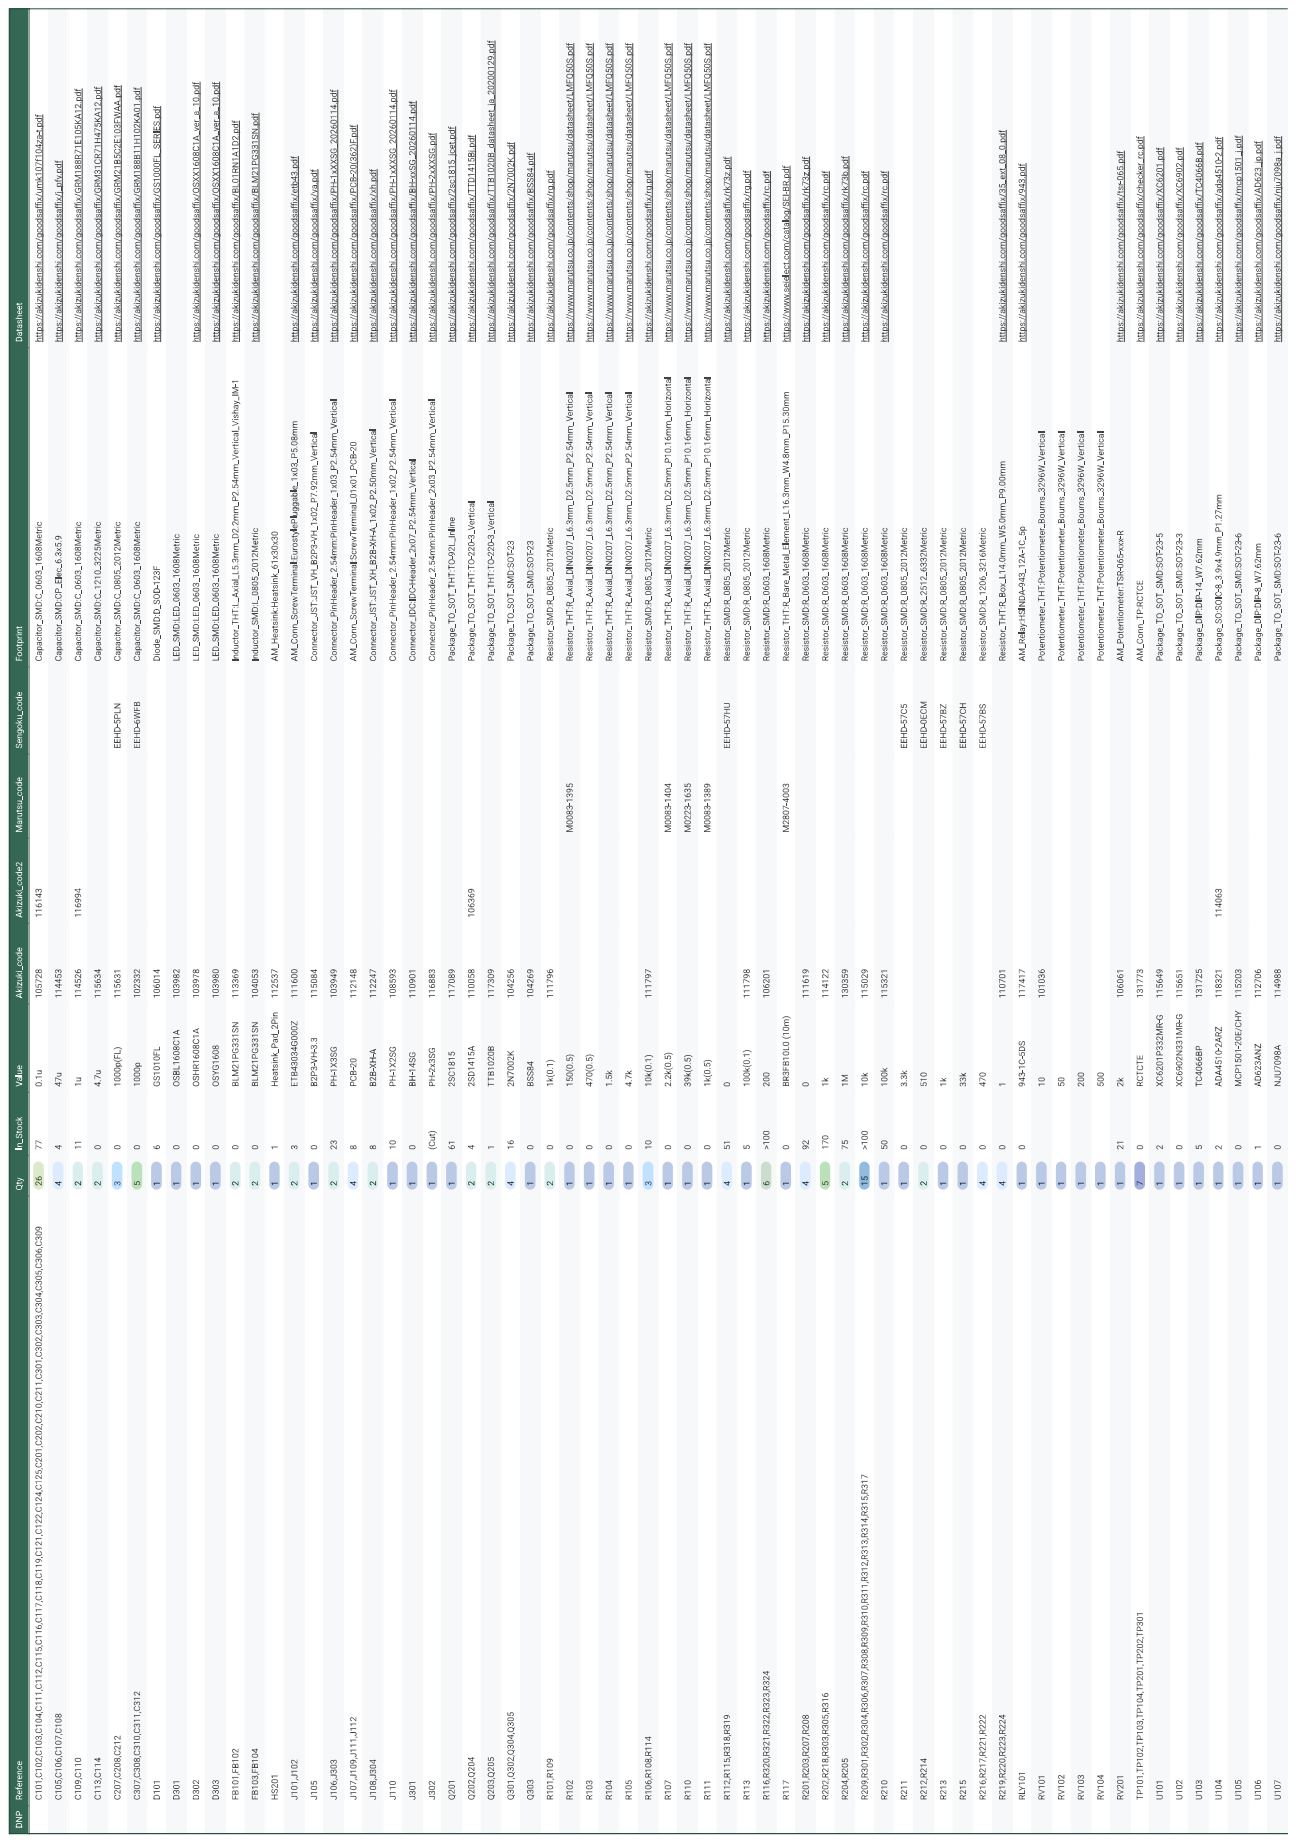
[picture p4: page 1]
