EosinY/ElectronicLoad-AnalogController/schem.pdf

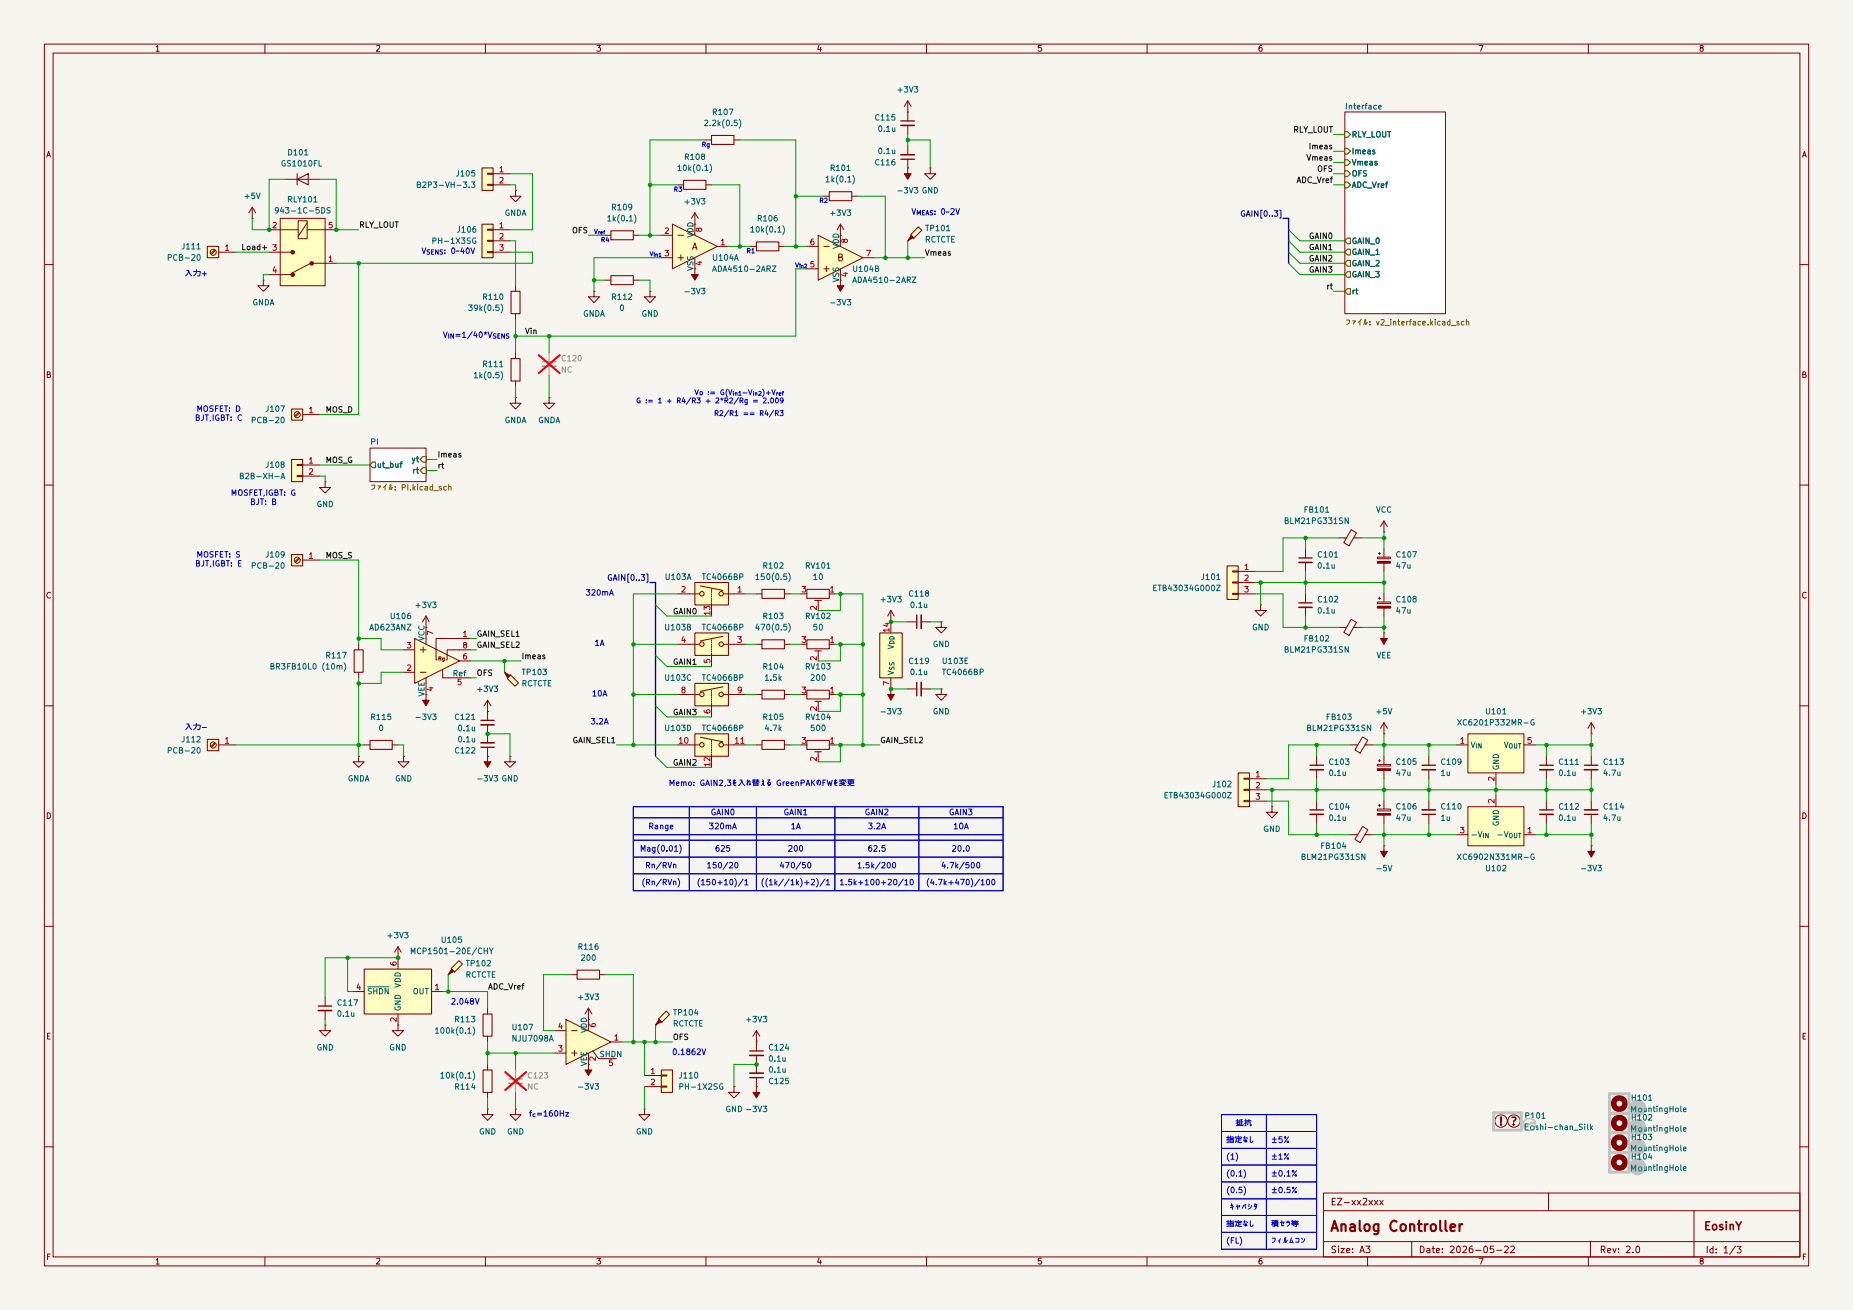
[picture p5: page 1]

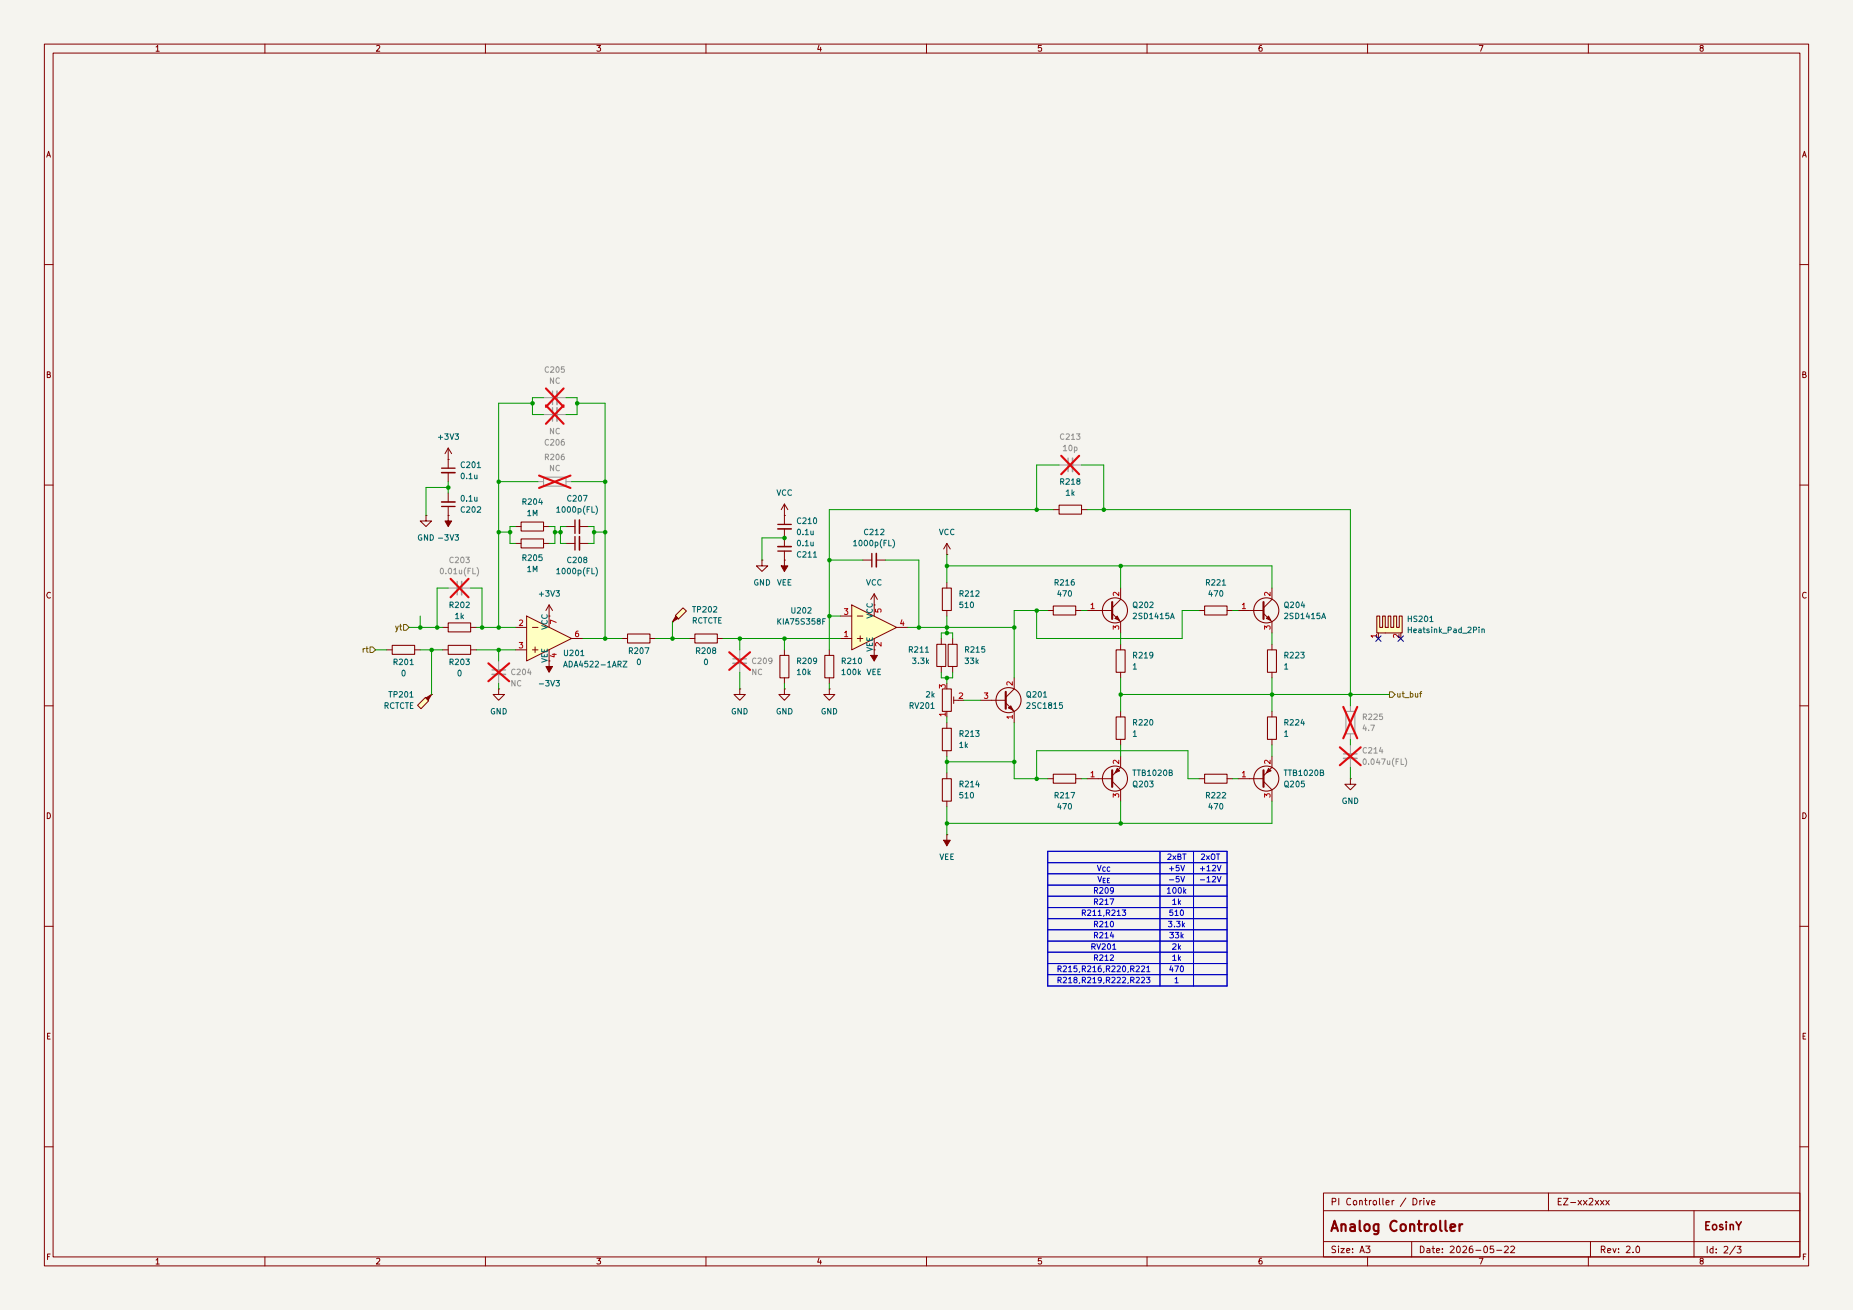
[picture p6: page 2]

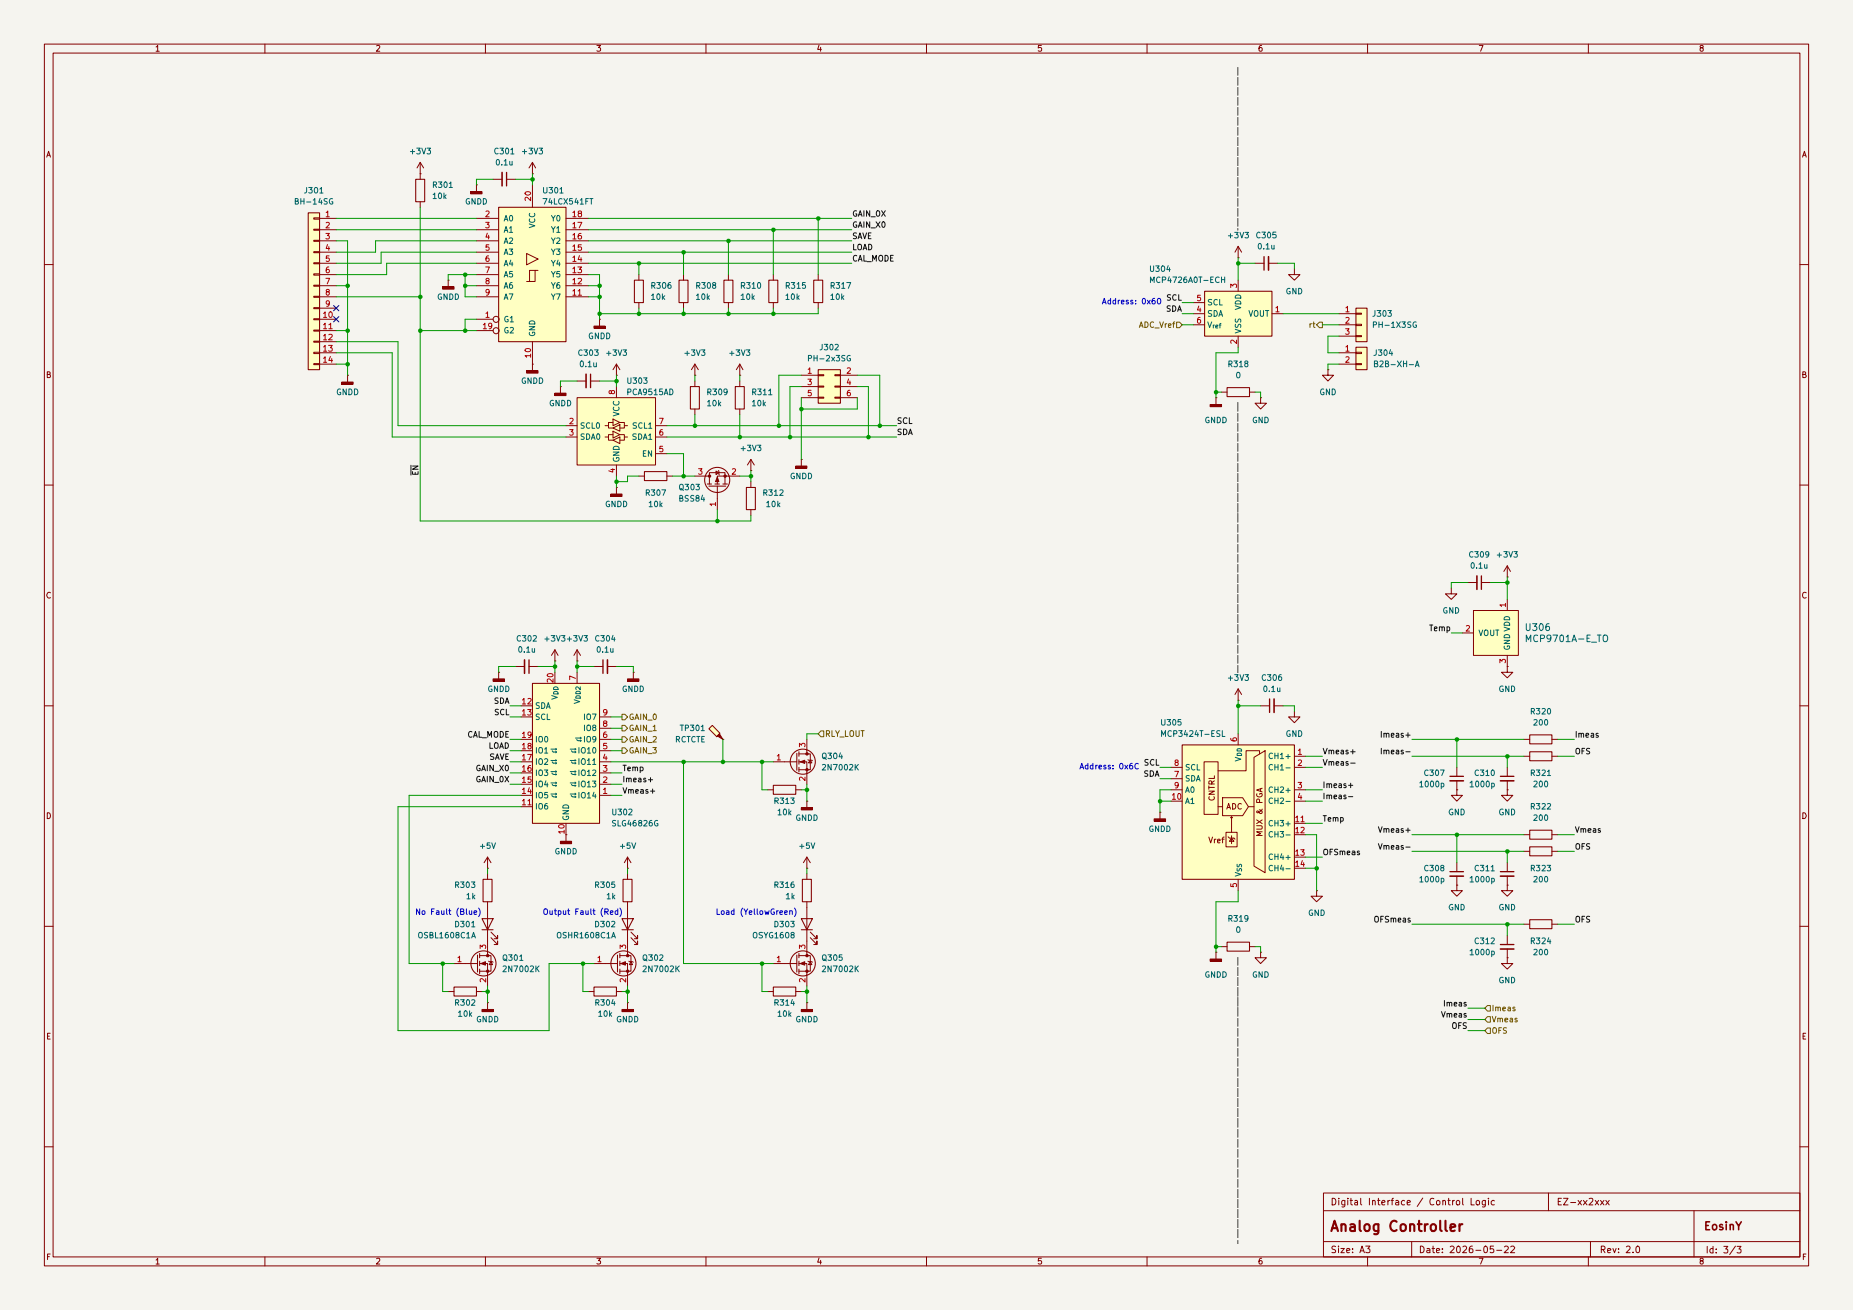
[picture p7: page 3]
