EosinY/ElectronicLoad-AnalogController/(commit log)

2025-03-12 JLCPCB plugin test
    [Main_SMD_Controller.kicad_pcb, bom.csv, designators.csv, positions.csv]
2025-03-12 JLCPCB plugin test 2
    [bom.csv, designators.csv, positions.csv]
2025-03-12 Add "Gerber" creation
2025-03-24 add BOM
    [Main_SMD_Controller.csv, Main_SMD_Controller.kicad_pcb, Main_SMD_Controller.kicad_sch]
2025-03-24 changed library
    [Main_SMD_Controller.csv, Main_SMD_Controller.kicad_pcb, Main_SMD_Controller.kicad_sch]
2025-04-04 Add negative power
    [Main_SMD_Controller.kicad_pcb, Main_SMD_Controller.kicad_sch]
2025-04-06 alpha 2
    [Main_SMD_Controller.kicad_pcb, Main_SMD_Controller.kicad_sch]
2025-04-23 fix pi controller
    [Main_SMD_Controller.kicad_sch, Main_SMD_Controller_2layer.kicad_pcb]
2025-04-23 4 layered
    [Main_SMD_Controller.kicad_pcb, Main_SMD_Controller.kicad_sch]
2025-04-24 fix voltage measure circuit
    [Main_SMD_Controller.kicad_pcb, Main_SMD_Controller.kicad_sch]
2025-04-27 bom and schematic pdf
    [Main_SMD_Controller.csv, Main_SMD_Controller.kicad_pcb, Main_SMD_Controller.kicad_sch]
2025-07-17 add v2 version
    [Main_SMD_Controller.kicad_sch, Main_SMD_Controller_v2-Power.kicad_sch, Main_SMD_Controller_v2.kicad_pcb, Main_SMD_Controller_v2.kicad_sch]
2025-11-13 デジタルIF
2025-11-17 電圧なににしよ
    [v2_interface.kicad_sch]
2025-11-19 Voltmeas simu
2025-11-19 おおまか
    [Main_SMD_Controller_v2.kicad_sch]
2025-11-19 おおまか２
    [v2_interface.kicad_sch]
2026-04-26 もうだめだ おしまいだ
    [Main_SMD_Controller_v2.kicad_sch, PIctrl.kicad_sch, v2_interface.kicad_sch]
2026-04-28 メインとPI制御の2分化
    [Main_SMD_Controller_v2.kicad_sch, v2_interface.kicad_sch]
2026-05-02 いらんやろ
2026-05-21 Create GreenPAK_schem and BOM
    [Main_SMD_Controller_v2.csv]
2026-05-23 念のため
    [Main_SMD_Controller_v2.kicad_pcb, Main_SMD_Controller_v2.kicad_sch, PI.kicad_sch, v2_interface.kicad_sch]
2026-05-23 部品配置
    [Main_SMD_Controller_v2.kicad_pcb, Main_SMD_Controller_v2.kicad_sch]
2026-05-23 ほぼ完成?
    [Main_SMD_Controller_v2.kicad_pcb, Main_SMD_Controller_v2.kicad_sch, v2_interface.kicad_sch]
2026-05-24 ほぼ完成
    [Main_SMD_Controller_v2.kicad_pcb, Main_SMD_Controller_v2.kicad_sch]
2026-05-25 アノテーション変更前
    [Main_SMD_Controller_v2.kicad_pcb, Main_SMD_Controller_v2.kicad_sch]
2026-05-25 アノテーションリセット 余計なもんも消す
    [Main_SMD_Controller_v2.kicad_pcb, Main_SMD_Controller_v2.kicad_sch, v2_interface.kicad_sch]
2026-05-26 図面とかBOMとか
    [Main_SMD_Controller_v2.csv]
2026-05-28 できたかも
    [Main_SMD_Controller_v2.csv, Main_SMD_Controller_v2.kicad_pcb, Main_SMD_Controller_v2.kicad_sch, PI.kicad_sch, v2_interface.kicad_sch]
2026-06-06 現状確定
    [Main_SMD_Controller_v2.kicad_pcb, Main_SMD_Controller_v2.kicad_sch, PI.kicad_sch, v2_interface.kicad_sch]
2026-06-11 資料同期
    [Main_SMD_Controller_v2.csv]
